Alapont/ARSE-Respirator/Img/prototipo-1.PNG

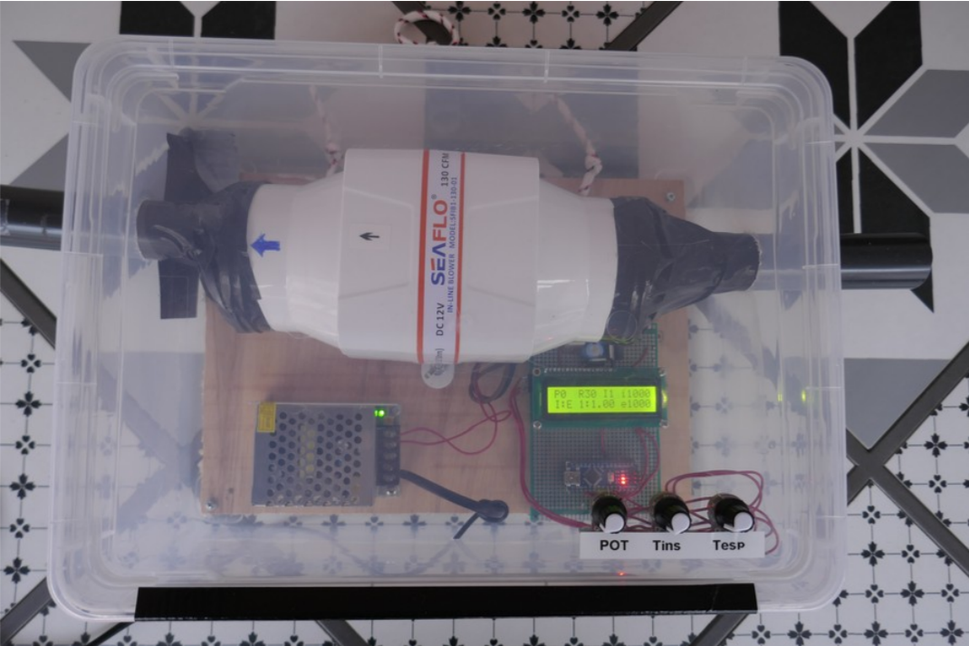
Img/prototipo-1.PNG
