Alapont/ARSE-Respirator/Readme.md

# Respirador ARSE
Proyecto para mantener la documentación sobre un respirador de bajo coste en castellano e inglés.

## Proyecto original
El proyecto original es el de construir un respirador barato con materiales fáciles de encontrar para situaciones de emergencia y desabastecimiento. El trabajo original es de Enrique Alapont Puchalt. 

## Estructura
Este proyecto sólo mantiene la documentación, aunque incluya el código original del autor. Esto se hace por anexar el código al documento.
Las carpetas *Sections* y *Sections-en* contienen los diferentes capítulos en castellano e inglés. Se selecciona una lista de capítulos u otra desde main.tex. Main también contiene siglas en uno u otro idioma.

## ¿Por qué ARSE?
Arse es el nombre Íbero de la ciudad de Sagunto. Por su significado en inglés, el nombre cambia a Edeta, nombre Íbero de la localización donde se encuentra Sagunto.

## Traducción
- Pablo Alapont
- Monica Prieto
- Pablo MacVeigh
- Tommy VanPottelbergh
