Alapont/ARSE-Respirator/Sections-en/Summary.tex

\section*{Summary}
\textit{This document describes the first design for a simple ventilator. Its simplicity will facilitate understanding, assembly, usage, maintenance and recycling.}\\
\textbf{Key words:} ventilator
