Alapont/ARSE-Respirator/Sections-en/Destruction.tex

\section{Destruction and Recycling}
    The device is conceived to work full time for a few months. At the end of the exceptional situation, which has motivated its design, it must be destroyed. It must be considered as bio-contaminated and must be disposed accordingly.
    %El aparato está concebido para funcionar contínuamente  unos pocos meses. Al terminar la situación de excepcionalidad que ha motivado su construcción, será destruido. Deberá ser considerado como biocontaminado y procederse en consecuencia.
