Alapont/ARSE-Respirator/Sections/Mantenimiento.tex

\section{Mantenimiento}
    El mantenimiento necesario en el interior es nulo. Externamente el respirador deberá ser lavado con una esponja y desinfectado cuando proceda.
