Alapont/ARSE-Respirator/Sections/Resumen.tex

\section*{Resumen}
\textit{
    El presente documento describe un primer diseño de un respirador sencillo para situaciones de emergencia. Su simplicidad facilitará la comprensión, la fabricación, el uso, el mantenimiento y el reciclado.
}\\
\\
\textbf{Palabras Clave:} respirador, ventilador
