Alapont/ARSE-Respirator/Img/Bloques.PNG

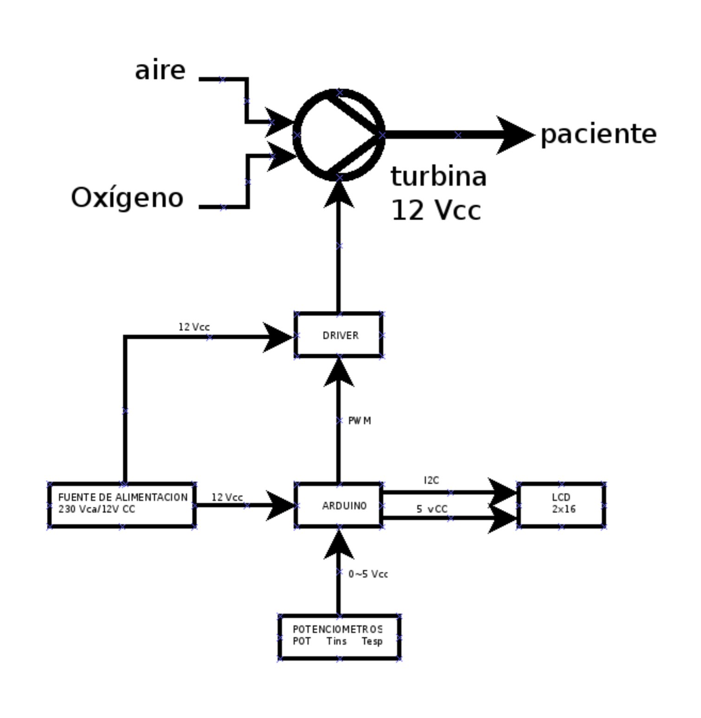
Img/Bloques.PNG
