Alapont/ARSE-Respirator/Sections-en/Build.tex

\section{Build}
    The electronic circuits are mounted over a printed circuit board. The display is  mounted with spacers over the circuit and connected with a flat 8 wire cable. The Arduino is mounted over the socket, everything else is soldered. Everything is mounted on the mounting plate, except the electronic circuit, whitch uses 5mm spacers.\\
    %Los circuitos electrónicos se montan sobre circuito impreso. El display se monta con separadores sobre el circuito y va conectado con un cable plano de 8 hilos. El Arduino va sobre zócalo, lo demás, soldado. Todo sobre la placa de montaje directamente, excepto el circuito electrónico, que va sobre separadores de 5 mm.\\
    
    The back plate is mounted with the case screws, the turbine uses M4 pins, everything else will use M3 screws. 
    %La placa trasera se monta con la tornillería que lleve la caja, La turbina, com pernos M4, todo lo demás con tornillería M3.
