Alapont/ARSE-Respirator/Sections-en/Operation.tex

\section{Operation}
    Turbine power will be selected from the front panel (0 - 100\%), inhaling and exhaling time (ranging from minimum to maximums as software defined).\\
    %Desde el panel frontal se seleccionará la potencia de la turbina (de 0 a 100\%), el tiempo de inspiración (desde mínimo a máximos programados) y el tiempo de espiración (con mínimo y máximo programados).\\
    
    The display provides the following information:
    %El display ofrece la siguiente información:
    \begin{itemize}
        \item Top row
        \begin{itemize}
            \item[--] P: Power, from 0 to 99\%
            \item[--] R: Breaths per minute (BPM) \footnote{Translator's Note: Respiraciones Por Minuto in original Spanish, therefore the R}
            \item[--] E/I Actual phase: I0, I1, E0, E1
            \item[--] i: Inhaling time, seconds
        \end{itemize}
        \item Bottom row
        \begin{itemize}
            \item[--] I:E: Inhale/Exhale ratio
            \item[--] E: Exhaling time
        \end{itemize}
    \end{itemize}
    
    The routine completes the inhale-exhale cycle in four phases: I0, I1, E0 and E1. Phases I0 and E0 are brief and only used for technical adjustments (E.g. the motor start). Almost the whole Inhaling is done at I1. E0 is not used.
    %El programa lleva a cabo el ciclo inspiración+espiración en cuatro fases: I0, I1, E0 y E1 en las que las fases I0 y E0 son muy breves y solo se usan para ajustes técnicos (como la arrancada del motor, por ejemplo), la casi totalidad de la inspiración se lleva a cabo en I1. E0 no se usa actualmente\\
    
    The selected times corresponds to:
    %Los tiempos seleccionados corresponden a;
    \begin{itemize}
        \item Inhale time: I0 + I1
        \item Exhale time: E0 + E1
    \end{itemize}
    
    In the actual design, the timing ratio is produced by selecting inhaling and exhaling time, showing Breaths Per Minute \footnote{TN: RPM in the original and R: in the screen} and its ratio I:E. It can be easily changed in the software for the potentiometers to select I:E ratio and Breaths Per Minute.
    %En el actual diseño la selección de tiempos se hace escogiendo los tiempos de inspiración y espiración y mostrando las RPM y la relación I:E. Puede fácilmente cambiarse el programa para que los potenciómetros seleccionen la relación I:E y las RPM.
