Alapont/ARSE-Respirator/Sections-en/Maintenance.tex

\section{Maintenance}
    No internal maintenance is neded. Externally, the respirator must be sponge-washed and disinfected when aplicable.
    %El mantenimiento necesario en el interior es nulo. Externamente el respirador deberá ser lavado con una esponja y desinfectado cuando proceda.
