Alapont/ARSE-Respirator/(commit log)

2020-04-10 Correcciones de Mac
2020-04-11 referencia al proyecto original y cambio de nombre
